PuceBaboon/ESP8266-DS3231/(threads)

Thread 1 (2019-03-04):

Having trouble determining the circuit employed

bprobbins, 2019-03-04:
Very intriguing idea you have here, but I am having no luck with figuring out the specific wiring connections as well as the correct p-channel mosfet. Could you elaborate on the hardware you used?

PuceBaboon, 2019-03-10:
Hi B.P.,

   I've been trying to find the original board with this circuit on it, but no luck so far (it was an ESP-03 module and that seems like such a long time ago now).  Anyway, the circuit is basically very, very similar to this one:-  [https://hackaday.io/project/12866/gallery#c051a7ad3baecf8c373875721df75253](https://hackaday.io/project/12866/gallery#c051a7ad3baecf8c373875721df75253)

   Ignore the large, obvious N-channel at the bottom; it's not required in the DS3231 circuit.  The key part is the smaller, P-channel MOSFET Q1, just above C1.  You can use this circuit pretty much as-is.  You don't need R4, R5 or Q2 (the N-channel MOSFET) at all.  Simply connect R3 to the SQW/INT pin of the DS3231 module instead.  The P-channel MOSFET must be one with a fairly low gate switching voltage (similar, or better, than the AO3415 shown in the diagram... it's other properties aren't too important, as long as it can handle in excess of 500ma of current).

   It's important to note that there needs to be a 3v3 regulator (preferably a low-quiescent current variety) between the output (marked as "PAD3" on the schematic) and the ESP8266/DS3231.

   Let me know if you have any other questions about this and, in the meantime, I'll try to make some time to add a schematic to the project sometime in the not-too-distant future.

                          -John-

bprobbins, 2019-03-10:
Hello John,
Thank you very much, that helps quite a bit.
Brian

bprobbins, 2019-03-21:
Thanks to your guidance, I put together this working circuit:
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

But I ran into trouble compiling your code with the rodan library, which must have changed since your code, so I tried out another DS3231 library as below and seems to work well:
```
#include <DS3232RTC.h>        // https://github.com/JChristensen/DS3232RTC
#include <Wire.h>
// For non-AVR boards only. Not needed for AVR boards.
DS3232RTC myRTC(false);     // tell constructor not to initialize the I2C bus.

void setup()
{
  Wire.begin(4,5);
  pinMode(2,OUTPUT); //alive indicator
  tmElements_t tm;
  tm.Hour = 00;               // set the RTC to an arbitrary time
  tm.Minute = 00;
  tm.Second = 00;
  tm.Day = 16;
  tm.Month = 9;
  tm.Year = 2017 - 1970;      // tmElements_t.Year is the offset from 1970
  myRTC.write(tm);              // set the RTC from the tm structure

  // set Alarm 1 to occur at 5 seconds after every minute
  myRTC.setAlarm(ALM1_MATCH_SECONDS, 5, 0, 0, 0);
  // configure the INT/SQW pin for "interrupt" operation (disable square wave output)
  myRTC.squareWave(SQWAVE_NONE);
  // enable interrupt output for Alarm 1
  myRTC.alarmInterrupt(ALARM_1, true);

  //*****************************************************//
  //This is where to put code that you want to run every
  //timed reset of the ESP
  //Optionally, show that ESP8266 is alive by flashing LED.
  for (int i = 0; i < 100; i++) {
    digitalWrite(2, LOW);
    delay(50);
    digitalWrite(2, HIGH);
    delay(50);
  }
  //*****************************************************//

  //Finally, clear the alarm flag which causes the DS3231 INT/SQW pin to
  //go high-z. As a result, the connected p-channel mosfet stops providing
  //power to ESP8266 and the ESP turns off, only to be reconnected to power
  //again when the DS3231 INT/SQW alarms and goes LOW one minute later
  myRTC.alarm(ALARM_1);

}//setup

void loop()
{
//NOTHING HERE
}//loop

```
Thanks again

bprobbins, 2019-03-21:
Actually, there is a big error in my schematic above. Sorry. Below is the correct (I think) setup:
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

PuceBaboon, 2019-03-23:
Excellent job, Brian.  Thanks for all of your work making that available.

Your choice of P-MOSFET looks interesting, too.  I just had a quick look at the data sheet; it seems just right for this application.  Where are you sourcing them and what's the tens-to-fifties pricing like?

Thanks for the update to your schematic.  I come from the old school (actually, "ancient school" is probably closer to the mark) where teacher insisted that you read a schematic left-to-right, just like a book, so the inputs were always on the left and the outputs on the right (this was in the days where there might be twenty sheets for a tape drive and fifty odd for a disk drive, so it made life a lot easier).  Anyway, your schematic is very much appreciated, especially as I've been meaning to re-visit this project with some ESP-Now sensors to push battery life even further (with an ESP32-to-ethernet gateway to handle the MQTT interfacing).

I've already "pinned" this issue and I'll add a reference to it in the README now.

Thanks again,

                                 -John-

bprobbins, 2019-03-23:
Thanks for your comments. I'm a bit ancient myself, but only in age. I'm just an unschooled hobbyist looking to learn more, so thanks for the tip on schematic drawing.
I purchased the DMP2045U-7 mosfets from Mouser.com for $0.29 each (10 or more). I really know nothing about mosfets, so when I saw that someone was reporting it as good to combine with a TPL5110, I decided to try it with the ds3231.
Brian

1CM69, 2019-08-19:
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

I had similar issues trying to compile & upload this code but I made a few alterations and it now works with the 'rodan' lib.

I inserted the missing reference:
`#define RTC_BUFF_SIZE 256`
just below the includes

references to `DS3231_INTCN` had to be changed to `DS3231_CONTROL_INTCN`

the reference to `DS3231_A2IE` had to be changed to `DS3231_CONTROL_A2IE`

;)

tech-freak, 2020-09-03:
> Your choice of P-MOSFET looks interesting, too. I just had a quick look at the data sheet; it seems just right for this application...
>
thank you for such an awesome project.
I can't get same mosfet , can you suggest something similar ?

I am working on battery operated fish feeder , hope this will be helpful for my project
- ESP8266 (Wemos D1 mini) is connected to TP4056 along with 18650 cell and 5V 1A power supply , servo motor powered is powered by 4 x AA batteries
I tried NTP (locally hosted) method but not getting success with waking at right time , it misses time mostly and skip job :/
here is the simple diagram
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

Thread 2 (2019-08-19):

Output Year is incorrect

1CM69, 2019-08-19:
Hi,
not that it really alters the running of the sketch in anyway but more of a looks type of issue, the year output is off by 100 years.

My RTC is initially setup via NTP:

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

visible in the above image is the output from running my sketch to get time from NTP, yes the time is an hour behind PC time as my NTP time is set to GMT but you can see that the year is correct at 2019.

In the image below it shows the date & time output from this sketch, you can see that the year is now 1919 but the month, day & time is correct.

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

Any ideas?

Thanks

1CM69, 2019-08-19:
Could it be something very simple as the formatting of the date i.e. from the NTP my date is formatted as DDMMYYYY
using this sketch the date is formatted as YYYYMMDD

Perhaps it is confusing the issue as the day is the 19th and the short year YY is also 19.

Maybe tomorrow it will be more apparent i.e.

it may show as 1919-08-20 or 1920-08-19.....

PuceBaboon, 2019-08-19:
Brian,

   If you're still having problems with this, I recommend searching for the
"Cave Pearl" project and then looking at his DS3231 pages.  Ed has done a
ton of work (over years) on integrating all of the great tips on both
hardware, software and testing of the Chinese made, DS3231 modules.  Apart
from anything else, it's a great read.

             -John-

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

1CM69, 2019-08-20:
I found this thread on arduino.cc forum:

https://forum.arduino.cc/index.php?topic=295768.0

It’s the same year issue I am having with the Rodan library, I’ll try the suggested fix & report back.

1CM69, 2019-08-21:
I made the changes as outlined in the thread in the above post and now the year is showing correctly.

Meins321, 2022-02-16:
So you did this to Fix:

[Apr. '15](https://forum.arduino.cc/t/rtc-ds3231-returning-the-wrong-year/285491/7)
gilbertg:
I tried the other lib guix mentioned. A boat load of compile errors. I looked in the original lib to see where it added the 1900, and I don’t have enough experience to notice it. I’m a total noob, so I’ll stick my nose back in the books and get some more learning under my belt. I don’t expect anyone to do it for me. Thanks again Very Much for the quick replies! Don’t worry…I’ll be back with more questions, I promise! :’)

I had the same problem today. **I found the DS3231.ccp file had mention of the year 1900. I’m not good with libraries (Noobie), but I replaced 1900 on line 76 with 2000, as well as line 117, then saved the file. No idea what I did, but the date now comes up as [2015.**](url)

PS. It has fixed one problem, but may have stuffed up a future one (my guess is turn of the century 2100). But my guess is that no one will be using this code then. We’ll probably program thru our home robotic assistance, or maybe in layman’s language (via Siri) or maybe even telepathically!

[DS3231.cpp](https://forum.arduino.cc/uploads/short-url/fmKIwGJ7EBIBGkbTdwcNldKV3CS.cpp) (9.79 KB)

[DS3231.cpp.zip](https://github.com/PuceBaboon/ESP8266-DS3231/files/8078652/DS3231.cpp.zip)

PuceBaboon, 2022-02-16:
Hi Meins321, Brian,

   Funnily enough, I've been doing a little bit more work with various versions of this project recently and, mainly because of maintenance issues, have swapped over to using the Adafruit RTClib library instead of the Rodan one.  It's not very difficult to modify the code and you can check https://github.com/PuceBaboon/ESP-DigiClock for hints on how to use it.

   If we get another big snow storm, I might have enough time on my hands to go back and update this project, but no promises on a timeline I'm afraid.  Here's the library.properties info from RTClib:-

RTClib
======
version=1.11.2
author=Adafruit
maintainer=Adafruit <info@adafruit.com>
sentence=A fork of Jeelab's fantastic RTC library
paragraph=A fork of Jeelab's fantastic RTC library
category=Timing
url=https://github.com/adafruit/RTClib
architectures=*
depends=TinyWireM

   -John-
