PuceBaboon/ESP8266-DS3231/(commit log)

2019-03-23 Added a reference to BPRobbins' schematic diagram in the issues
2019-03-23 Minor crrection tu bed spooling und grimmer.
2021-10-02 Update README.md
    Change the single-line description to more accurately state "control power" rather than "supply power".
2022-02-17 Uploaded power-latch schematic and linked into README.md
2022-02-17 Updated with latest version, including external pins for DS3231 -INT/SQW and GND connections.
2022-02-17 Update with hardware description of circuit.
2022-02-22 Added info on Power-Latch PCB.
2022-02-22 Added picture of one-button WiFi remote control.
2022-02-22 Changed position and link for one-button thumbnail.
